Ladniy/jiran-ble-lite/README.md

Title Image

Wireless ergo-split keyboard, based on [Holyiot-18010 (nRF52840)](http://www.holyiot.com/tp/2019042516322180424.pdf) module.

* __Author:__ [@ladniys (Telegram)](https://t.me/ladniys) [u/Ladniy (Reddit)](https://reddit.com/u/Ladniy)
* __Layout:__ [keyboard-layout-editor.com](http://www.keyboard-layout-editor.com/#/gists/0e1e37be1416db32917622ca0f6ad490)
* __Hardware Availability:__ [Open Source](https://github.com/Ladniy/jiran-ble-lite/releases/tag/v1.1.1)
* __Firmware:__ [ZMK](https://zmk.dev/)

Check out [wiki-page](https://github.com/Ladniy/jiran-ble-lite/wiki) for more information.

## Project status

**The keyboard is fully functional, no problems were noticed.**

## License

This project is licensed under a [CERN-OHL-P v2.0](https://ohwr.org/project/cernohl/wikis/Documents/CERN-OHL-version-2).

Feel free to use, share, modify or even sell Jiran BLE Lite!

## Credits

Many thanks to:

* [joric](https://github.com/joric) - hardware support;
* [krikun98](https://github.com/krikun98) - firmware and hardware support;
* [kgusakov](https://github.com/kgusakov) - firmware support;
