Ladniy/jiran-ble-lite/case/other-material-pinkyless/case.dxf

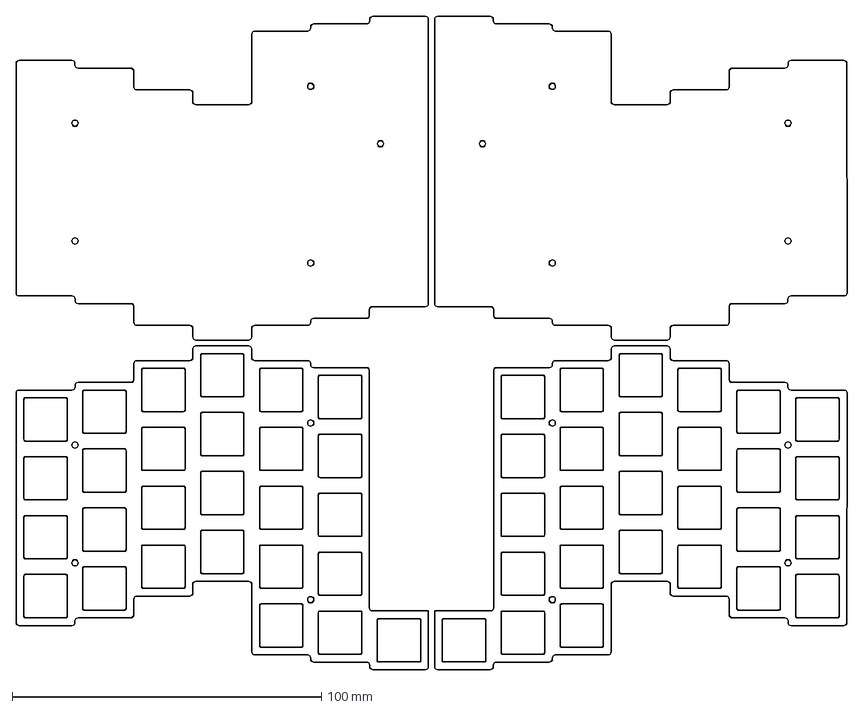
[picture p1: CAD file, 2021-10-27]
case/other-material-pinkyless/case.dxf
268.7 x 211.3 mm
