Ladniy/jiran-ble-lite/case/other-material/case.dxf

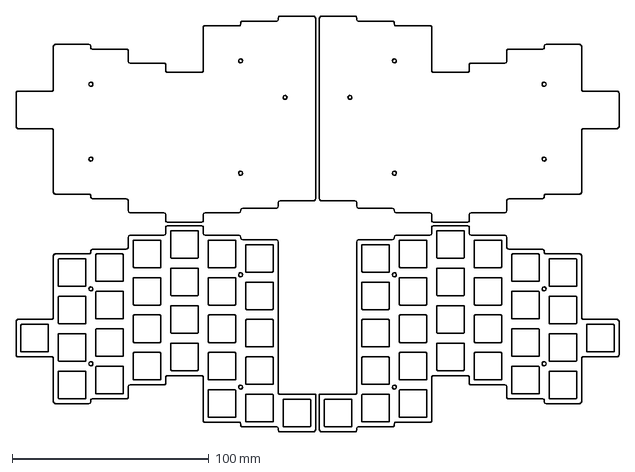
[picture p2: CAD file, 2021-10-27]
case/other-material/case.dxf
306.7 x 211.3 mm
