Ladniy/jiran-ble-lite/(list of files, cad)

Other CAD files:
case/other-material-pinkyless/case.dwg
case/other-material/case.dwg
