Ladniy/jiran-ble-lite/case/other-material-pinkyless/case.pdf

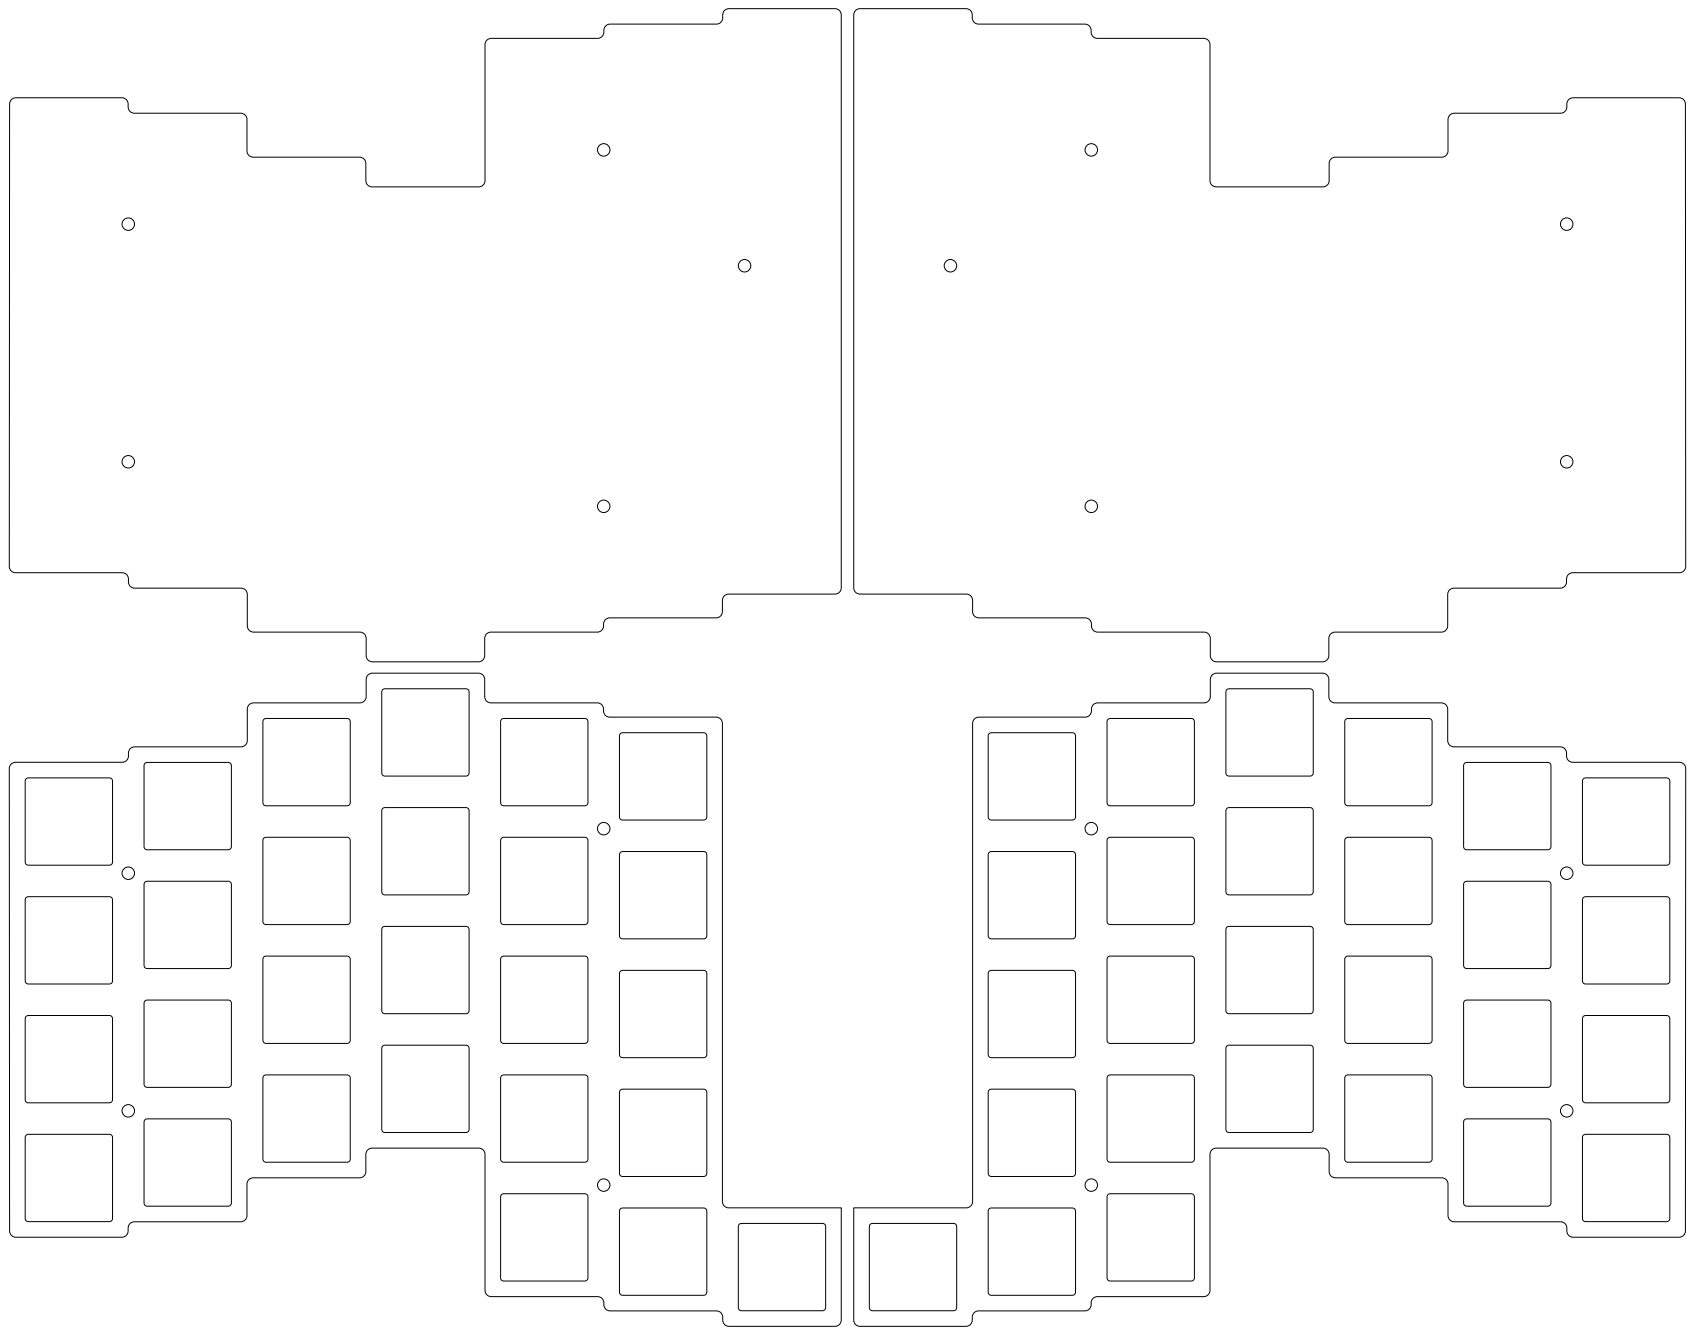
[picture p3: page 1]
