Ladniy/jiran-ble-lite/case/other-material/case.pdf

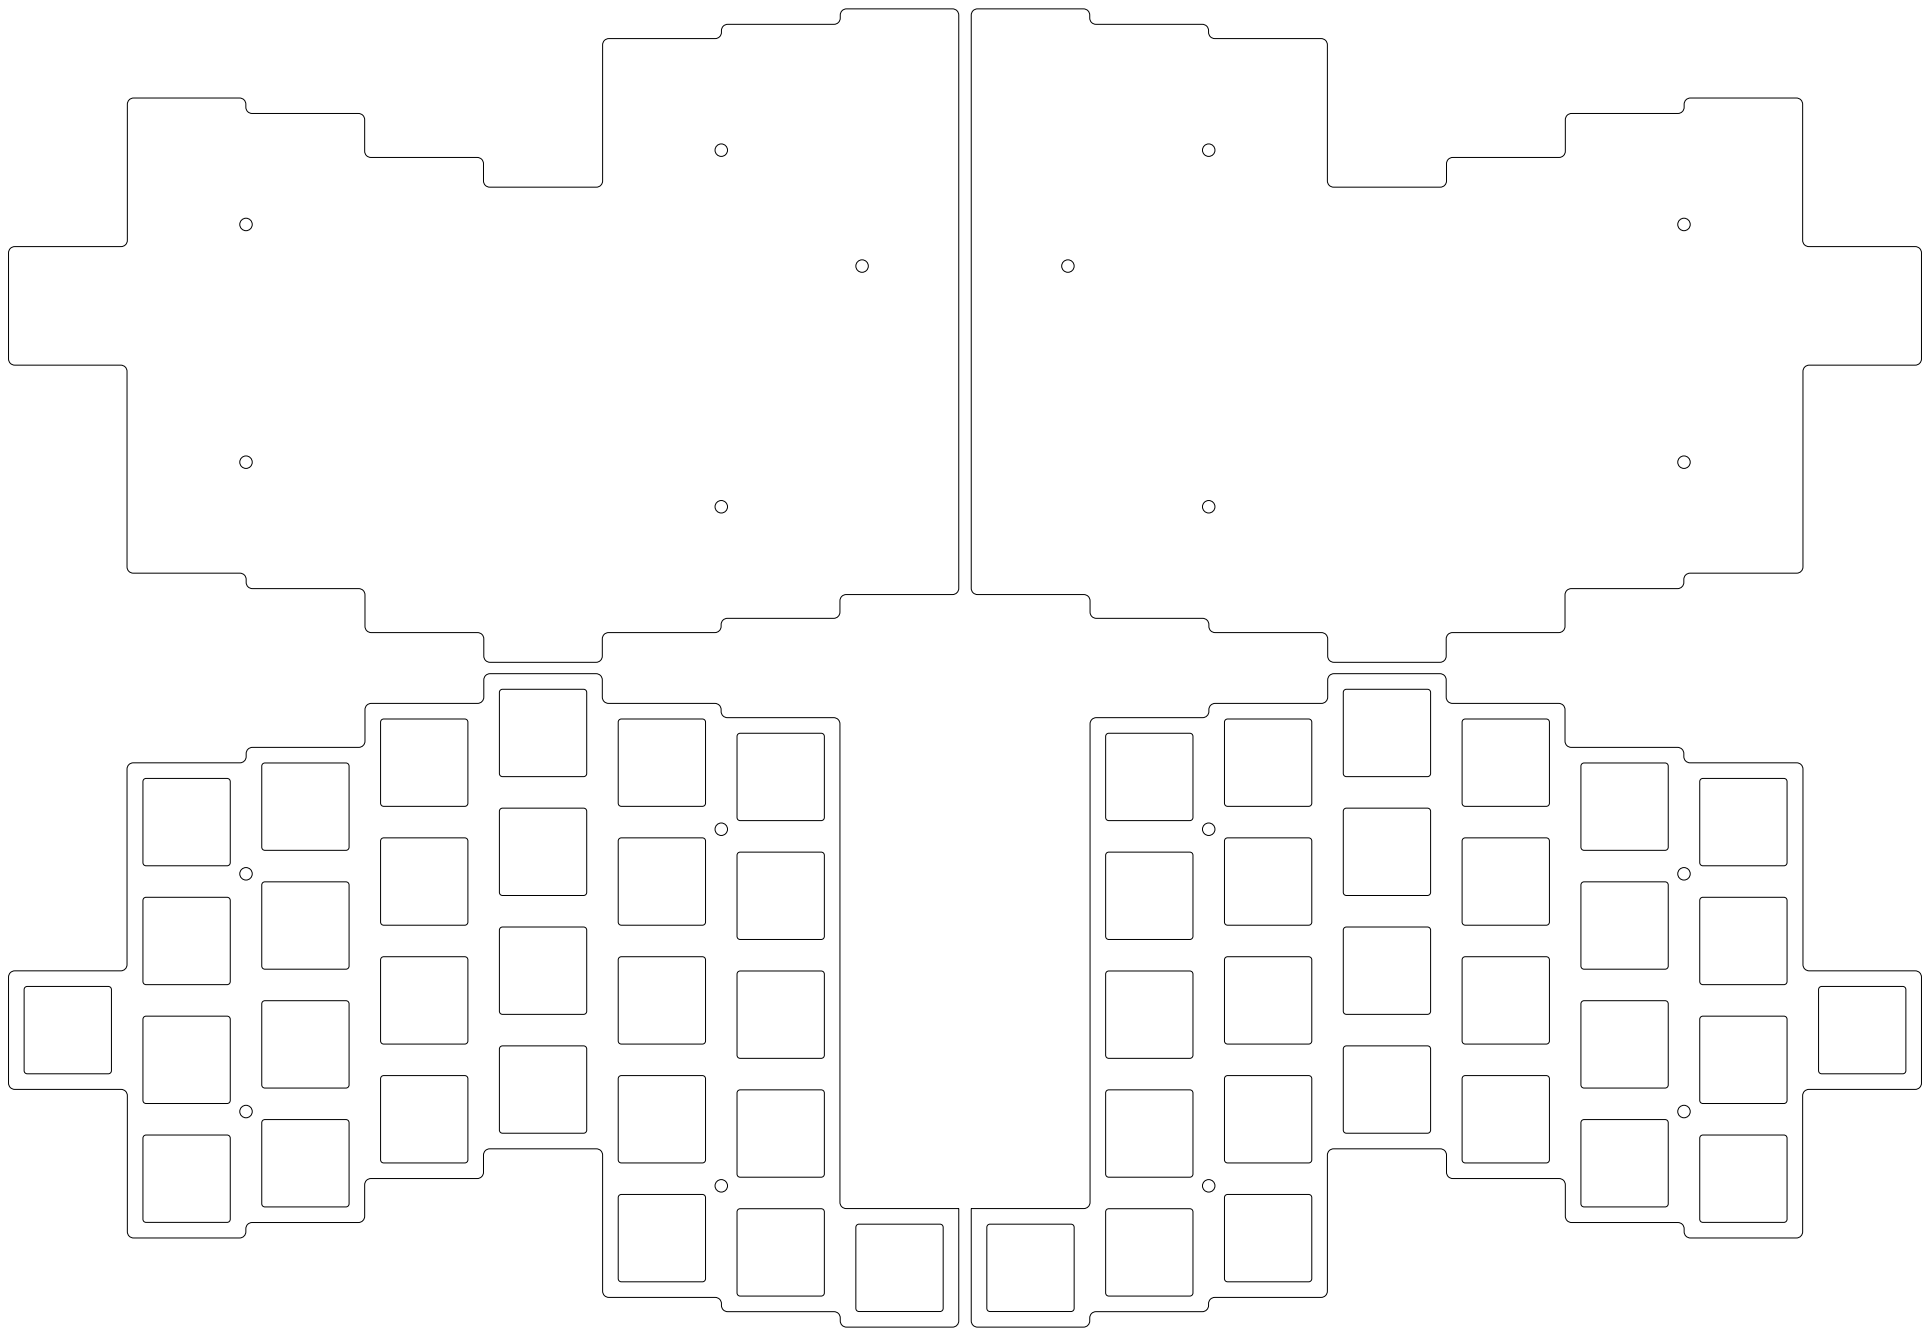
[picture p4: page 1]
