Ladniy/jiran-ble-lite/(list of files, drawings)

Other design files:
pcb/jiran-ble-lite/jiran-ble-lite.dsn
