Ladniy/jiran-ble-lite/(commit log)

2021-05-27 Create KiCad project
    [jiran-ble-lite.kicad_pcb, jiran-ble-lite.kicad_sch]
2021-05-31 Create hierarchical sheet for right half
    [jiran-ble-lite-right.kicad_sch, jiran-ble-lite.kicad_sch]
2021-06-03 Finish schematic
    [jiran-ble-lite-right.kicad_sch, jiran-ble-lite.kicad_sch]
2021-06-03 Remove contains
    [jiran-ble-lite-right.kicad_sch, jiran-ble-lite.kicad_sch]
2021-06-04 Import footprints from jiran ble project
2021-06-04 Add NPTH mount hole
2021-06-04 Remove global labels
    [jiran-ble-lite-right.kicad_sch, jiran-ble-lite.kicad_sch]
2021-06-04 Little cosmetic fix
    [jiran-ble-lite.kicad_sch]
2021-06-04 Remove pwr flag
    [jiran-ble-lite-right.kicad_sch]
2021-06-04 Assign footprints
    [jiran-ble-lite-right.kicad_sch, jiran-ble-lite.kicad_sch]
2021-06-05 Place switches and diodes on the left half
    [jiran-ble-lite.kicad_pcb]
2021-06-06 Update 3d models for each footprint
2021-06-06 Backups update
    [jiran-ble-lite.kicad_pcb]
2021-06-06 Create footprint for reset switch
2021-06-06 Change footprint for reset switch
    [jiran-ble-lite-right.kicad_sch, jiran-ble-lite.kicad_pcb, jiran-ble-lite.kicad_sch]
2021-06-06 Update PCB footprints
2021-06-07 Create footprint for 0805 package resistor
2021-06-07 Create footprint for 0805 package LED
2021-06-07 Change assigned footprints
    [jiran-ble-lite-right.kicad_sch, jiran-ble-lite.kicad_pcb, jiran-ble-lite.kicad_sch]
2021-06-10 GND pin is rectangle now
2021-06-10 Move resistor and blue led
    [jiran-ble-lite.kicad_pcb]
2021-06-10 Move reset switch
    [jiran-ble-lite.kicad_pcb]
2021-06-11 Draw footprint for 16350 nickel holder
2021-06-11 Draw footprint for 18650 nickel holder
2021-06-11 Change battery footprint
    [jiran-ble-lite-right.kicad_sch, jiran-ble-lite.kicad_sch]
2021-06-11 Create 3d model for battery holder
2021-06-11 Move battery holder and LDO
    [jiran-ble-lite.kicad_pcb]
2021-06-11 Remove LED indicator
    [jiran-ble-lite-right.kicad_sch, jiran-ble-lite.kicad_sch]
2021-06-11 Remove LED and resistor
    [jiran-ble-lite.kicad_pcb]
2021-06-11 Create arcs in BLE module cut
    [jiran-ble-lite.kicad_pcb]
2021-06-12 Assign 3D model of battery
2021-06-12 Add 3D model of battery
2021-06-12 Move battery holders
    [jiran-ble-lite.kicad_pcb]
2021-06-12 Update footprints
    [jiran-ble-lite.kicad_pcb]
2021-06-12 Place switches at right half
    [jiran-ble-lite.kicad_pcb]
2021-06-12 Place all diodes at right half
    [jiran-ble-lite.kicad_pcb]
2021-06-12 Cosmetic fix
    [jiran-ble-lite.kicad_pcb]
2021-06-12 Swap pins on power switch
    [jiran-ble-lite-right.kicad_sch]
2021-06-12 Place breakoff panel footprints
    [jiran-ble-lite.kicad_pcb]
2021-06-12 Complete edge cuts line
    [jiran-ble-lite.kicad_pcb]
2021-06-12 Draw keepout area
    [jiran-ble-lite.kicad_pcb]
2021-06-12 Create files for routing
    [jiran-ble-lite.dsn]
2021-06-12 Route tracks
    [jiran-ble-lite.kicad_pcb]
2021-06-12 Create footprint from BMP
2021-06-12 Swap footprints
    [jiran-ble-lite.kicad_sch]
2021-06-12 Place front silk footprint
2021-06-12 Create footprint from BMP (back)
2021-06-12 Change logo footprint
    [jiran-ble-lite-right.kicad_sch, jiran-ble-lite.kicad_sch]
2021-06-12 Save more space for mount hole
2021-06-12 Update footprint from BMP
2021-06-13 Remove diode from power scheme
    [jiran-ble-lite-right.kicad_sch, jiran-ble-lite.kicad_sch]
2021-06-13 Remove diode from PCB
    [jiran-ble-lite.kicad_pcb]
2021-06-13 Move LDO
    [jiran-ble-lite.kicad_pcb]
2021-06-13 Move battery and power switch footprints
    [jiran-ble-lite.kicad_pcb]
2021-06-13 Move power text
    [jiran-ble-lite.kicad_pcb]
2021-06-13 Add silk with revision
    [jiran-ble-lite.kicad_pcb]
2021-06-13 Increase line width
    [jiran-ble-lite.kicad_pcb]
2021-06-13 Route tracks, fill all zones
    [jiran-ble-lite.dsn]
2021-06-13 Remove CR123A battery holder 3d model
2021-06-13 Remove a lot of unused footprints
2021-06-13 Update footprints on PCB
2021-06-13 Plot gerber files
    [jiran-ble-lite-B_Cu.gbl, jiran-ble-lite-B_Mask.gbs, jiran-ble-lite-B_Silkscreen.gbo, jiran-ble-lite-Edge_Cuts.gm1, jiran-ble-lite-F_Cu.gtl, jiran-ble-lite-F_Mask.gts, jiran-ble-lite-F_Silkscreen.gto, jiran-ble-lite-NPTH.drl]
2021-06-13 Create archive with gerber files
2021-06-16 Re-check some sizes and footprints
2021-06-16 Draw a lot of source files for case design
    [Bottom_LEFT.dxf, PCB_Edge_Cuts.dxf, PCB_Edge_Cuts_LEFT.dxf, PCB_Edge_Cuts_LEFT_Switches.dxf, PCB_Edge_Cuts_Switches.dxf, Plate_LEFT.dxf, jiran-ble-lite-Edge_Cuts.dxf]
2021-06-22 Create step model of PCB
2021-06-22 Plot some dxf files
    [jiran-ble-lite-B_Cu.dxf, jiran-ble-lite-Edge_Cuts.dxf, jiran-ble-lite-F_Cu.dxf]
2021-06-23 Draw USB-C circuit
    [jiran-ble-lite.kicad_sch]
2021-06-23 Update power circuit
    Add mosfet, diode and resistor
    [jiran-ble-lite.kicad_sch]
2021-06-24 Increase net label font size
    [jiran-ble-lite.kicad_sch]
2021-06-24 Redraw keyboard matrix
    [jiran-ble-lite.kicad_sch]
2021-06-26 Annotate all symbols
    [jiran-ble-lite-right.kicad_sch, jiran-ble-lite.kicad_sch]
2021-06-27 Assign 3d model to footprint
2021-06-27 Add new footprints
2021-06-27 Assign symbols to footprints
    [jiran-ble-lite-right.kicad_sch, jiran-ble-lite.kicad_sch]
2021-06-27 Remove all tracks
    [jiran-ble-lite.kicad_pcb]
2021-06-27 Update PCB from schematic
    [jiran-ble-lite.kicad_pcb]
2021-06-27 Fix net lable error
    [jiran-ble-lite-right.kicad_sch, jiran-ble-lite.kicad_sch]
2021-06-27 Change sot-23 footprint
    [jiran-ble-lite-right.kicad_sch, jiran-ble-lite.kicad_sch]
2021-06-27 Place all components at the left half
    [jiran-ble-lite.kicad_pcb]
2021-06-27 Move silk footprints
    [jiran-ble-lite.kicad_pcb]
2021-06-27 Remove some old silk
    [jiran-ble-lite.kicad_pcb]
2021-06-27 Remove battery polarity silk
    [jiran-ble-lite.kicad_pcb]
2021-06-27 Place all components at right half
    [jiran-ble-lite.kicad_pcb]
2021-06-27 Move all diodes
    [jiran-ble-lite.kicad_pcb]
2021-06-27 Fix matrix pinouts
    [jiran-ble-lite.kicad_sch]
2021-06-27 Fix power switch pins
    [jiran-ble-lite-right.kicad_sch]
2021-06-28 Export DSN file for routing
    [jiran-ble-lite.dsn, jiran-ble-lite.kicad_pcb]
2021-07-02 Move power circuit
    [jiran-ble-lite.kicad_pcb]
2021-07-02 Move diode and resistors
    [jiran-ble-lite.kicad_pcb]
2021-08-25 Draw cutoffs for breakoff pinky key
    [jiran-ble-lite.kicad_pcb]
2021-08-25 Update diode footprint
    [jiran-ble-lite.kicad_pcb]
2021-08-25 Import new dsn file for routing
    [jiran-ble-lite.dsn]
2021-08-25 Edit breakoff cutout
    [jiran-ble-lite.kicad_pcb]
2021-08-26 Move diodes under switch footprins
    [jiran-ble-lite.kicad_pcb]
2021-08-26 Draw battery silkscreen
    [jiran-ble-lite.kicad_pcb]
2021-08-26 Export new dsn file for routing
    [jiran-ble-lite.dsn]
2021-08-26 Update route files
    [jiran-ble-lite.dsn]
2021-08-26 Plot new gerbers
    [jiran-ble-lite-B_Cu.gbl, jiran-ble-lite-B_Mask.gbs, jiran-ble-lite-B_Silkscreen.gbo, jiran-ble-lite-Edge_Cuts.gm1, jiran-ble-lite-F_Cu.gtl, jiran-ble-lite-F_Mask.gts, jiran-ble-lite-F_Silkscreen.gto, jiran-ble-lite-NPTH.drl]
2021-08-29 Draw basic case
    [case.dwg, case.dxf]
2021-08-29 Remove old files
    [Bottom_LEFT.dxf, PCB_Edge_Cuts.dxf, PCB_Edge_Cuts_LEFT.dxf, PCB_Edge_Cuts_LEFT_Switches.dxf, PCB_Edge_Cuts_Switches.dxf, Plate_LEFT.dxf, jiran-ble-lite-Edge_Cuts.dxf]
2021-09-01 Remove some holes
    [jiran-ble-lite-right.kicad_sch, jiran-ble-lite.kicad_pcb, jiran-ble-lite.kicad_sch]
2021-09-01 Draw new breakoff cutout for pinky key
    [jiran-ble-lite.kicad_pcb]
2021-09-01 Edit battery silkscreen
    [jiran-ble-lite.kicad_pcb]
2021-09-01 Update USB-C footprint
    [jiran-ble-lite.kicad_pcb]
2021-09-01 Add keepout area
    [jiran-ble-lite.kicad_pcb]
2021-09-01 Route USB-C and battery pins
    [jiran-ble-lite.kicad_pcb]
2021-09-01 Import files for routing
    [jiran-ble-lite.dsn]
2021-09-01 Route all tracks
    [jiran-ble-lite.kicad_pcb]
2021-10-12 Design new plate
    [plate.kicad_pcb]
2021-10-12 Create cutoff for pinky key
    [plate.kicad_pcb]
2021-10-12 Fill all zones
    [plate.kicad_pcb]
2021-10-12 Plate backups update
2021-10-12 Update plot directory
    [plate.kicad_pcb]
2021-10-12 Design new underplate
    [underplate.kicad_pcb]
2021-10-12 Plot gerbers files
2021-10-12 Draw new footprints for case
2021-10-12 Fix matrix pins
    [jiran-ble-lite-right.kicad_sch, jiran-ble-lite.kicad_sch]
2021-10-12 Increase hole diameter
2021-10-12 Remove track and zones
2021-10-12 Update PCB with changes made to schematic
2021-10-12 Update hole mount footprint
    [jiran-ble-lite.kicad_pcb]
2021-10-12 Increase silkscreen width
    [jiran-ble-lite.kicad_pcb]
2021-10-12 Fix charm silkscreen
    [jiran-ble-lite.kicad_pcb]
2021-10-12 Route USB-C data pins
    [jiran-ble-lite.kicad_pcb]
2021-10-13 Remove old gerbers
    [jiran-ble-lite-B_Cu.gbl, jiran-ble-lite-B_Mask.gbs, jiran-ble-lite-B_Silkscreen.gbo, jiran-ble-lite-Edge_Cuts.gm1, jiran-ble-lite-F_Cu.gtl, jiran-ble-lite-F_Mask.gts, jiran-ble-lite-F_Silkscreen.gto, jiran-ble-lite-NPTH.drl]
2021-10-13 Plot new gerber files
    [jiran-ble-lite-B_Cu.gbl, jiran-ble-lite-B_Mask.gbs, jiran-ble-lite-B_Silkscreen.gbo, jiran-ble-lite-Edge_Cuts.gm1, jiran-ble-lite-F_Cu.gtl, jiran-ble-lite-F_Mask.gts, jiran-ble-lite-F_Silkscreen.gto, jiran-ble-lite-NPTH.drl]
2021-10-13 Edit cutout, re-fill zones
    [plate.kicad_pcb]
2021-10-13 Clean up
    [jiran-ble-lite.dsn]
2021-10-19 Design pinky-less case
    [case.dwg, case.dxf]
2021-10-19 Remove fifth mount hole
    [case.dwg, case.dxf]
2021-10-26 Increase camera duration
2021-10-27 Fix line thickness
    [case.dwg, case.dxf]
2021-11-01 Create catalog for pcb renders
2021-11-01 Create renders fith fr-4 case
2022-02-16 Add new footprint to lib
2022-02-16 New KiCad version save & Change usb-c footprint
    [jiran-ble-lite-right.kicad_sch, jiran-ble-lite.dsn, jiran-ble-lite.kicad_sch]
2022-02-20 New silkscreen with QR code
2022-02-20 Re-assign footprints
    [jiran-ble-lite-right.kicad_sch, jiran-ble-lite.kicad_sch]
2022-02-20 Take a new screenshot of PCB
2022-02-20 Fix GND trace
2022-02-20 Plot new gerbers after fix
    [jiran-ble-lite-B_Cu.gbl, jiran-ble-lite-B_Mask.gbs, jiran-ble-lite-B_Silkscreen.gbo, jiran-ble-lite-Edge_Cuts.gm1, jiran-ble-lite-F_Cu.gtl, jiran-ble-lite-F_Mask.gts, jiran-ble-lite-F_Silkscreen.gto, jiran-ble-lite-NPTH.drl]
2022-07-18 Add resistors for battery status & change footprints
    [jiran-ble-lite-right.kicad_sch, jiran-ble-lite.kicad_sch]
2022-07-18 Update resistors footprints
    [jiran-ble-lite-right.kicad_sch, jiran-ble-lite.kicad_sch]
2022-07-18 Remove old unused net label
    [jiran-ble-lite-right.kicad_sch, jiran-ble-lite.kicad_sch]
2022-07-18 Place resistors & route tracks & fill zones
    [jiran-ble-lite.dsn]
2022-07-18 Update gerbers
    [jiran-ble-lite-B_Cu.gbl, jiran-ble-lite-B_Mask.gbs, jiran-ble-lite-B_Silkscreen.gbo, jiran-ble-lite-Edge_Cuts.gm1, jiran-ble-lite-F_Cu.gtl, jiran-ble-lite-F_Mask.gts, jiran-ble-lite-F_Silkscreen.gto, jiran-ble-lite-NPTH.drl]
